jaytektas/grblHAL_CNC/grblHAL.jpg

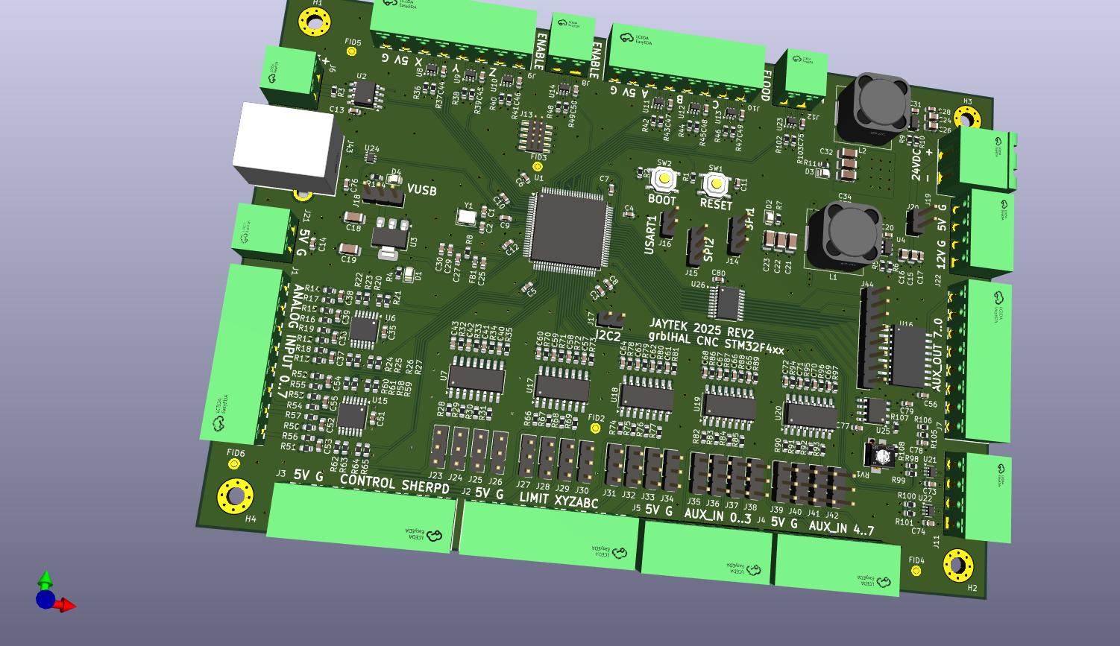
grblHAL.jpg
