jaytektas/grblHAL_CNC/user manual.odt

# JAYTEK Controller User Manual Index

## <a id="index-1-introduction"></a>1. Introduction

- 1.1 Welcome and Overview (https://www.google.com/search?q=%23section-1-1-welcome-and-overview)
- 1.2 Safety Precautions (https://www.google.com/search?q=%23section-1-2-safety-precautions)
  - Electrical Safety (https://www.google.com/search?q=%23section-1-2-electrical-safety)
  - Mechanical Safety (https://www.google.com/search?q=%23section-1-2-mechanical-safety)
  - Fire Safety (https://www.google.com/search?q=%23section-1-2-fire-safety)
  - General Workshop Safety (https://www.google.com/search?q=%23section-1-2-general-workshop-safety)
  - Disclaimer (https://www.google.com/search?q=%23section-1-2-disclaimer)
- 1.3 About GRBLHAL (https://www.google.com/search?q=%23section-1-3-about-grblhal)

## <a id="index-2-controller-features-and-specifications"></a>2. Controller Features and Specifications

- 2.1 Key Features Summary (https://www.google.com/search?q=%23section-2-1-key-features-summary)
- 2.2 Technical Specifications (https://www.google.com/search?q=%23section-2-2-technical-specifications)
  - Microcontroller (https://www.google.com/search?q=%23section-2-2-microcontroller)
  - Power Supply (https://www.google.com/search?q=%23section-2-2-power-supply)
  - Motion Control (https://www.google.com/search?q=%23section-2-2-motion-control)
  - Connectivity (https://www.google.com/search?q=%23section-2-2-connectivity)
  - Physical (https://www.google.com/search?q=%23section-2-2-physical)

## <a id="index-3-hardware-overview-and-connections"></a>3. Hardware Overview and Connections

- 3.1 Board Layout Diagram (https://www.google.com/search?q=%23section-3-1-board-layout-diagram)
- 3.2 Pinout Diagrams / Tables (https://www.google.com/search?q=%23section-3-2-pinout-diagrams-tables)
  - CONTROL INPUT - J3 (https://www.google.com/search?q=%23section-3-2-control-input-j3)
  - LIMIT INPUT – J2 (https://www.google.com/search?q=%23section-3-2-limit-input-j2)
  - DIGITAL 0..3 INPUT – J5 (https://www.google.com/search?q=%23section-3-2-digital-0-3-input-j5)
  - DIGITAL 4..7 INPUT – J4 (https://www.google.com/search?q=%23section-3-2-digital-4-7-input-j4)
  - SPINDLE OUTPUT – J11 (https://www.google.com/search?q=%23section-3-2-spindle-output-j11)
  - AUXILIARY OUTPUT – J7 (https://www.google.com/search?q=%23section-3-2-auxiliary-output-j7)
  - 5 & 12V OUTPUT – J22 (https://www.google.com/search?q=%23section-3-2-5-12v-output-j22)
  - 12 – 24VDC IN SUPPLY – J19 (https://www.google.com/search?q=%23section-3-2-12-24vdc-in-supply-j19)
  - COOLANT OUTPUT – J12 (https://www.google.com/search?q=%23section-3-2-coolant-output-j12)
  - ABC STEP OUTPUT – J10 (https://www.google.com/search?q=%23section-3-2-abc-step-output-j10)
  - ENABLE OUTPUT – J8 (https://www.google.com/search?q=%23section-3-2-enable-output-j8)
  - XYZ STEP OUTPUT – J9 (https://www.google.com/search?q=%23section-3-2-xyz-step-output-j9)
  - RS485 OUTPUT – J6 (https://www.google.com/search?q=%23section-3-2-rs485-output-j6)
  - 5V OUT – J21 (https://www.google.com/search?q=%23section-3-2-5v-out-j21)
  - ANALOG INPUT – J1 (https://www.google.com/search?q=%23section-3-2-analog-input-j1)
- 3.3 Axis Stepper Motor Connections (https://www.google.com/search?q=%23section-3-3-axis-stepper-motor-connections)
  - 3.3.1 Control Signal Connections (JAYTEK Controller to Stepper Driver) (https://www.google.com/search)
  - 3.3.2 Motor Coil Connections (Stepper Driver to Stepper Motor) (https://www.google.com/search)
  - 3.3.3 Power Connections (Stepper Driver) (https://www.google.com/search?q=%23section-3-3-3-power-connections-stepper-driver)
- 3.4 Spindle Control Output (https://www.google.com/search?q=%23section-3-4-spindle-control-output)
  - 3.4.1 Connecting to a Variable Frequency Drive (VFD) (https://www.google.com/search?q=%23section-3-4-1-connecting-to-a-variable-frequency-drive-vfd)
  - 3.4.2 Connecting to an External DC Motor Driver (https://www.google.com/search?q=%23section-3-4-2-connecting-to-an-external-dc-motor-driver)
  - 3.4.3 RS485 Spindle Control (https://www.google.com/search?q=%23section-3-4-3-rs485-spindle-control)
- 3.5 Limit Switch and Probe Connections (https://www.google.com/search?q=%23section-3-5-limit-switch-and-probe-connections)
  - 3.5.1 Limit Switch Inputs (https://www.google.com/search?q=%23section-3-5-1-limit-switch-inputs)
  - 3.5.2 Probe Input (https://www.google.com/search?q=%23section-3-5-2-probe-input)
  - 3.5.3 Control Inputs (Feed Hold, Cycle Start/Resume, Reset) (https://www.google.com/search?q=%23section-3-5-3-control-inputs-feed-hold-cycle-start-resume-reset)
  - 3.5.4 Emergency Stop (E-Stop) (https://www.google.com/search?q=%23section-3-5-4-emergency-stop-e-stop)
- 3.6 Coolant Outputs (Mist and Flood) (https://www.google.com/search?q=%23section-3-6-coolant-outputs-mist-and-flood)
- 3.7 Auxiliary Outputs (J7) (https://www.google.com/search?q=%23section-3-7-auxiliary-outputs-j7)
- 3.8 Expansion Breakouts (UART, I2C, SPI) (https://www.google.com/search?q=%23section-3-8-expansion-breakouts-uart-i2c-spi)
  - 3.8.1 UART (USART) Breakout (https://www.google.com/search?q=%23section-3-8-1-uart-usart-breakout)
  - 3.8.2 I2C (Inter-Integrated Circuit) Breakout (https://www.google.com/search?q=%23section-3-8-2-i2c-inter-integrated-circuit-breakout)
  - 3.8.3 SPI (Serial Peripheral Interface) Breakout (https://www.google.com/search?q=%23section-3-8-3-spi-serial-peripheral-interface-breakout)
- 3.9 Firmware Flashing via DFU (Device Firmware Upgrade) (https://www.google.com/search?q=%23section-3-9-firmware-flashing-via-dfu-device-firmware-upgrade)
  - Method 1: Entering DFU Mode via Hard Reset (when initially unpowered or only USB powered) (https://www.google.com/search)
  - Method 2: Entering DFU Mode via Soft Reset (when already powered via J19 or USB) (https://www.google.com/search)
  - Flashing the Firmware (https://www.google.com/search?q=%23section-3-9-flashing-the-firmware)
- 3.10 Powering the Controller (https://www.google.com/search?q=%23section-3-10-powering-the-controller)
  - 3.10.1 Main Power Input (J19) (https://www.google.com/search?q=%23section-3-10-1-main-power-input-j19)
  - 3.10.2 USB Power (https://www.google.com/search?q=%23section-3-10-2-usb-power)
    - 3.10.2.1 CPU 3.3V Derivation (J18) (https://www.google.com/search?q=%23section-3-10-2-1-cpu-3-3v-derivation-j18)
  - 3.10.3 On-board Power Supply Outputs (https://www.google.com/search?q=%23section-3-10-3-on-board-power-supply-outputs)
  - 3.10.4 Isolated Grounding Philosophy (https://www.google.com/search?q=%23section-3-10-4-isolated-grounding-philosophy)

# JAYTEK Controller User Manual

## <a id="section-1-introduction"></a>1. Introduction

### <a id="section-1-1-welcome-and-overview"></a>1.1 Welcome and Overview

Welcome to the user manual for your new JAYTEK controller! This powerful and versatile controller is designed to be the brain of your CNC machine, translating digital commands into precise physical movements. Whether you're a dedicated hobbyist or managing a small workshop, the JAYTEK controller provides the robust control you need for accurate and efficient machining.

This manual will guide you through the setup, configuration, and operation of your JAYTEK controller, helping you unlock its full potential for your CNC projects.

### <a id="section-1-2-safety-precautions"></a>1.2 Safety Precautions

This section is CRITICAL for your safety and the longevity of your equipment. Please read it carefully and adhere to all warnings.

#### <a id="section-1-2-electrical-safety"></a>Electrical Safety:

- Always disconnect power from the JAYTEK controller and all connected components (spindle, stepper drivers, power supplies) before performing any wiring, maintenance, or inspection.
- Ensure proper grounding of your CNC machine frame and high-power electrical components (like stepper driver power supplies and VFDs). For the JAYTEK controller itself, adhere to the isolated grounding philosophy (https://www.google.com/search?q=%23section-3-10-4-isolated-grounding-philosophy) to protect its sensitive electronics from noise. Improper grounding or incorrect isolation can lead to electrical shock and damage.
- Never operate the controller or machine with damaged cables or exposed wires.
- Verify that your power supply voltage and current ratings are compatible with the JAYTEK controller's requirements (Max 30VDC input). Over-voltage can cause irreparable damage.
- Avoid contact with live circuits. If you are not comfortable working with electrical components, seek assistance from a qualified electrician.

#### <a id="section-1-2-mechanical-safety"></a>Mechanical Safety:

- Be aware of moving parts of the CNC machine. Keep hands, clothing, and long hair clear of the spindle, gantry, and other moving axes.
- Identify and avoid pinch points where moving parts could trap body parts or clothing.
- Always wear appropriate eye protection (safety glasses or a face shield) when operating the CNC machine to guard against flying debris.
- Ensure all mechanical components are securely fastened before operation.

#### <a id="section-1-2-fire-safety"></a>Fire Safety:

- The spindle and power supplies can generate heat. Ensure adequate ventilation around all components to prevent overheating.
- Keep a fire extinguisher (appropriate for electrical and material fires) readily accessible in your workshop.
- Be cautious when machining materials that produce flammable dust or fumes.
- Regularly clean dust and debris from your machine and workspace to reduce fire hazards.

#### <a id="section-1-2-general-workshop-safety"></a>General Workshop Safety:

- Maintain a clean and organized workspace to minimize tripping hazards and improve overall safety.
- Do not operate the CNC machine while under the influence of alcohol, drugs, or medications that impair judgment.
- Familiarize yourself with the emergency stop (E-stop) procedure and ensure it is easily accessible and functional.
- Never leave the machine unattended during operation, especially during long cuts.

#### <a id="section-1-2-disclaimer"></a>Disclaimer:

Incorrect installation, configuration, or use of the JAYTEK controller and associated CNC machinery can lead to serious injury, property damage, or fire. The user assumes all risks associated with the assembly, operation, and maintenance of their CNC system. It is the user's responsibility to understand and comply with all applicable safety regulations and best practices.

### <a id="section-1-3-about-grblhal"></a>1.3 About GRBLHAL

GRBLHAL is an open-source, high-performance, and highly optimized firmware specifically designed for 32-bit microcontrollers, such as the STM32 series. It serves as a powerful control system for CNC machines, taking G-code commands and translating them into precise real-time movements of the machine's axes.

GRBLHAL was chosen for this controller due to its significant advantages over traditional 8-bit GRBL versions:

- Increased Processing Power: The STM32F4xx microcontroller offers considerably more processing power, allowing for smoother motion, faster communication, and the ability to handle more complex calculations and features without stuttering.
- Enhanced Features: Its 32-bit architecture supports advanced functionalities like 6-axis control, more versatile spindle options, and expanded input/output capabilities, which are fully utilized by this controller.
- Reliability and Stability: GRBLHAL is known for its robust and stable performance, crucial for precise CNC operations.
- Active Community and Development: Being open-source, GRBLHAL benefits from continuous development and a large, supportive community, ensuring ongoing improvements and resources.

For more in-depth information about GRBLHAL, including its source code, documentation, and community forums, please visit the official GRBLHAL repository on GitHub:

- GRBLHAL GitHub Repository: https://github.com/grblHAL/grblHAL (https://www.google.com/search?q=https://github.com/grblHAL/grblHAL)
- JAYTEK Controller (STM32F4xx) Specific Firmware: https://github.com/jaytektas/STM32F4xx (https://www.google.com/search?q=https://github.com/jaytektas/STM32F4xx)

## <a id="section-2-controller-features-and-specifications"></a>2. Controller Features and Specifications

### <a id="section-2-1-key-features-summary"></a>2.1 Key Features Summary

The JAYTEK controller is engineered with a comprehensive set of features to provide robust and flexible control for a variety of CNC applications. Below is a summary of its core capabilities:

- Six-Axis Control: The controller supports 6 axes (X, Y, Z, A, B, C). X, Y, and Z are generally used for primary linear motion. Axes A, B, and C can be configured for rotary, additional linear, or specialized applications. Note: The controller's default firmware is configured for auto-squaring during homing, ganging the C-axis with the Y-axis to facilitate this feature.
- PWM Spindle Control: Integrated Pulse Width Modulation (PWM) spindle control allows for precise management of spindle speed. This typically supports a 0-10V analog output for variable frequency drives (VFDs) and a PWM output for direct control of compatible spindles or solid-state relays. The RPM range is software-configurable, allowing you to match your specific spindle's capabilities. Additionally, dedicated enable and direction pins provide comprehensive spindle management, along with RS485 support for advanced communication with intelligent spindles.
- USB Connectivity: High-speed USB communication provides a reliable and fast interface with your host PC. This connection is used for sending G-code, receiving status updates, and configuring the controller. The controller can also be powered via USB for bench programming and initial setup without requiring an external power supply.
- UART Breakout: Multiple Universal Asynchronous Receiver/Transmitter (UART) breakout pins are available, providing serial communication capabilities. These can be utilized for connecting external displays, Bluetooth modules, Wi-Fi modules, or other serial-enabled peripherals to expand the controller's functionality.
- I2C Breakout: Inter-Integrated Circuit (I2C) breakout pins offer a two-wire serial bus interface. This is ideal for connecting various I2C-compatible sensors (e.g., temperature, pressure, accelerometer), real-time clocks, or character LCDs to provide additional feedback or control.
- SPI Breakout: Serial Peripheral Interface (SPI) breakout pins are provided for high-speed synchronous serial communication. SPI is suitable for interfacing with additional peripherals such as SD card readers, advanced sensors, or other modules that require fast data exchange.
- Dual On-board Power Supply (12V and 5V @ 3A): The controller integrates dual onboard Switching Mode Power Supplies (SMPS) that provide regulated 12V and 5V outputs, each capable of supplying up to 3 Amperes of current. This eliminates the need for external power regulation for many connected peripherals, simplifying wiring and reducing component count. These supplies are derived from the main 30VDC input. It's important to consider the total power draw of all connected devices to ensure these supplies are not overloaded.
- Status LEDs: The JAYTEK controller includes clear status LEDs for 12V, 5V, 3.3V, and USB power. These indicators provide immediate visual feedback on the power status of critical internal rails and the USB connection, aiding in troubleshooting and verification.
- Input/Output Pins: A comprehensive array of input/output (I/O) pins is available for essential machine control and safety features:
  - Limit Switches: Individual axis limit stop inputs for all 6 axes ensure the machine operates within safe physical boundaries.
  - Probe Input: A dedicated probe input allows for precise tool length measurement, work coordinate system setting, and automatic leveling.
  - Control Inputs: Dedicated inputs for E-stop (emergency stop), Cycle Start, Hold (pause), Resume, Reset, and Door interlock provide critical operator control and safety mechanisms.
  - Coolant Outputs: Mist and flood coolant outputs allow for automated control of cutting fluid delivery, improving tool life and surface finish.
  - Auxiliary Digital Inputs (8x opto-isolated): These inputs can be used for a wide range of custom functions, such as tool changers, vacuum pumps, dust collection, or additional safety interlocks. The opto-isolation provides protection against electrical noise and ground loops for critical inputs.
  - Auxiliary Analog Inputs (8x): These inputs can be used for various analog sensors, suchs as temperature, pressure, or custom feedback systems.
  - Auxiliary Low-Side Drivers (8x): These outputs are capable of driving relays, small solenoids, or LED indicators, providing additional control capabilities for various machine accessories.

### <a id="section-2-2-technical-specifications"></a>2.2 Technical Specifications

#### <a id="section-2-2-microcontroller"></a>Microcontroller

- Model: STM32F407VET6

#### <a id="section-2-2-power-supply"></a>Power Supply

- Input Voltage Range: 12V-30V DC (preferred 24V DC for main power)
- On-board Power Supply Outputs:
  - 12V @ 3A
  - 5V @ 3A

#### <a id="section-2-2-motion-control"></a>Motion Control

- Number of Axes: 6
- Stepper Driver Interface: Step/Dir/Enable signals, compatible with common drivers such as A4988, DRV8825, TMC2209, DM542, and DM556.
- Spindle Control: PWM (Pulse Width Modulation) & Analog 0 - 10V
  - Frequency: (To be specified based on requirements, e.g., 1kHz typical)
  - Duty Cycle Range: 0-100%

#### <a id="section-2-2-connectivity"></a>Connectivity

- USB: USB-B port
- Pin Headers for Communication Protocols:
  - UART
  - I2C
  - SPI

#### <a id="section-2-2-physical"></a>Physical

- Dimensions: 150mm x 105mm
- Mounting Holes: 4 mounting holes, 3.2mm diameter, located 6mm from each corner (X and Y)
  - Coordinates (assuming origin at bottom-left corner):
    - (6mm, 6mm)
    - (144mm, 6mm)
    - (6mm, 99mm)
    - (144mm, 99mm)

## <a id="section-3-hardware-overview-and-connections"></a>3. Hardware Overview and Connections

### <a id="section-3-1-board-layout-diagram"></a>3.1 Board Layout Diagram

(Image or Diagram Placeholder - Please refer to your physical manual or JAYTEK documentation for the actual diagram.)

### <a id="section-3-2-pinout-diagrams-tables"></a>3.2 Pinout Diagrams / Tables

Note on Connectors: All connectors on the JAYTEK controller are removable terminal blocks. This design feature significantly simplifies the wiring process. Users can detach the individual connector blocks from their sockets, comfortably install wires into the screw terminals, and then securely push the wired connector blocks back into their corresponding sockets on the board. This eliminates the need to work with wires directly on the mounted board.

#### <a id="section-3-2-control-input-j3"></a>CONTROL INPUT - J3

PIN | FUNCTION | DIRECTION
1 | 5V | OUT
2 | GND | COMMON
3 | CYCLE START | IN
4 | CYCLE HOLD | IN
5 | EMERGENCY STOP | IN
6 | RESET | IN
7 | PROBE | IN
8 | DOOR | IN

#### <a id="section-3-2-limit-input-j2"></a>LIMIT INPUT – J2

PIN | FUNCTION | DIRECTION
1 | 5V | OUT
2 | GND | COMMON
3 | LIMIT X | IN
4 | LIMIT Y | IN
5 | LIMIT Z | IN
6 | LIMIT A | IN
7 | LIMIT B | IN
8 | LIMIT C | IN

#### <a id="section-3-2-digital-0-3-input-j5"></a>DIGITAL 0..3 INPUT – J5

PIN | FUNCTION | DIRECTION
1 | 5V | OUT
2 | GND | COMMON
3 | AUXILIARY INPUT 0 | IN
4 | AUXILIARY INPUT 1 | IN
5 | AUXILIARY INPUT 2 | IN
6 | AUXILIARY INPUT 3 | IN

#### <a id="section-3-2-digital-4-7-input-j4"></a>DIGITAL 4..7 INPUT – J4

PIN | FUNCTION | DIRECTION
1 | 5V | OUT
2 | GND | COMMON
3 | AUXILIARY INPUT 4 | IN
4 | AUXILIARY INPUT 5 | IN
5 | AUXILIARY INPUT 6 | IN
6 | AUXILIARY INPUT 7 | IN

#### <a id="section-3-2-spindle-output-j11"></a>SPINDLE OUTPUT – J11

PIN | FUNCTION | DIRECTION
1 | SPINDLE 5V PWM | OUT
2 | SPINDLE ENABLE | OUT
3 | SPINDLE DIRECTION | OUT
4 | SPINDLE SPEED ANALOG 0-10V | OUT

#### <a id="section-3-2-auxiliary-output-j7"></a>AUXILIARY OUTPUT – J7

PIN | FUNCTION | DIRECTION
1 | AUXILIARY #7 | OUT
2 | AUXILIARY #6 | OUT
3 | AUXILIARY #5 | OUT
4 | AUXILIARY #4 | OUT
5 | AUXILIARY #3 | OUT
6 | AUXILIARY #2 | OUT
7 | AUXILIARY #1 | OUT
8 | AUXILIARY #0 | OUT

#### <a id="section-3-2-5-12v-output-j22"></a>5 & 12V OUTPUT – J22

PIN | FUNCTION | DIRECTION
1 | +12V | OUT
2 | GND | COMMON
3 | +5V | OUT
4 | GND | COMMON

#### <a id="section-3-2-12-24vdc-in-supply-j19"></a>12 – 24VDC IN SUPPLY – J19

PIN | FUNCTION | DIRECTION
1 | GND | COMMON
2 | +12V | IN

#### <a id="section-3-2-coolant-output-j12"></a>COOLANT OUTPUT – J12

PIN | FUNCTION | DIRECTION
1 | MIST | OUT
2 | FLOOD | OUT

#### <a id="section-3-2-abc-step-output-j10"></a>ABC STEP OUTPUT – J10

PIN | FUNCTION | DIRECTION
1 | STEP C | OUT
2 | DIRECTION C | OUT
3 | STEP B | OUT
4 | DIRECTION B | OUT
5 | STEP A | OUT
6 | DIRECTION A | OUT
7 | GND | COMMON
8 | +5V | OUT

#### <a id="section-3-2-enable-output-j8"></a>ENABLE OUTPUT – J8

PIN | FUNCTION | DIRECTION
1 | ENABLE | OUT
2 | ENABLE | OUT

#### <a id="section-3-2-xyz-step-output-j9"></a>XYZ STEP OUTPUT – J9

PIN | FUNCTION | DIRECTION
1 | STEP Z | OUT
2 | DIRECTION Z | OUT
3 | STEP Y | OUT
4 | DIRECTION Y | OUT
5 | STEP X | OUT
6 | DIRECTION X | OUT
7 | GND | COMMON
8 | +5V | OUT

#### <a id="section-3-2-rs485-output-j6"></a>RS485 OUTPUT – J6

PIN | FUNCTION | DIRECTION
1 | RS485+ | IN/OUT
2 | RS485- | IN/OUT

#### <a id="section-3-2-5v-out-j21"></a>5V OUT – J21

PIN | FUNCTION | DIRECTION
1 | +5V | OUT
2 | GND | COMMON

#### <a id="section-3-2-analog-input-j1"></a>ANALOG INPUT – J1

PIN | FUNCTION | DIRECTION
1 | ANALOG #0 | OUT
2 | ANALOG #1 | OUT
3 | ANALOG #2 | OUT
4 | ANALOG #3 | OUT
5 | ANALOG #4 | OUT
6 | ANALOG #5 | OUT
7 | ANALOG #6 | COMMON
8 | ANALOG #7 | OUT

### <a id="section-3-3-axis-stepper-motor-connections"></a>3.3 Axis Stepper Motor Connections

Wiring Stepper Drivers and Motors: Stepper motors are the workhorses of your CNC machine, translating electrical pulses into precise rotational movements. These motors are controlled by stepper drivers, which act as intermediaries, taking low-power control signals from your JAYTEK controller and converting them into the higher-power pulses needed to drive the motor coils. This section details the critical connections required for your stepper motors to function correctly:

- Control Signal Connections: How your JAYTEK controller communicates with each stepper driver.
- Motor Coil Connections: How each stepper driver connects to its respective stepper motor.
- Power Connections: Providing the necessary power to the stepper drivers.

We will focus on common bipolar stepper motors with 4 wires, as these are most prevalent in CNC applications, and drivers that use the standard "Step/Dir/Enable" interface.

#### <a id="section-3-3-1-control-signal-connections-jaytek-controller-to-stepper-driver"></a>3.3.1 Control Signal Connections (JAYTEK Controller to Stepper Driver)

Your JAYTEK controller provides dedicated Step, Direction, and combined Enable signals for each of its 6 axes (X, Y, Z, A, B, C). These are 5V logic signals. Each stepper driver will have corresponding inputs to receive these signals.

Common Control Signal Pins on Stepper Drivers:

- STEP (or PUL, PULS, CP): This input receives a pulsed signal from the controller. Each pulse instructs the stepper motor to advance by one "step" (or microstep, depending on your driver's settings).
  - Connect the STEP_X pin from your JAYTEK controller (e.g., J9 Pin 5 for X-axis) to the STEP input on your X-axis stepper driver.
  - Repeat this for all other axes (Y, Z, A, B, C), using the corresponding STEP pins from J9 (for Y, Z) and J10 (for A, B, C).
- DIR (or CW/CCW, D): This input receives a high (e.g., 5V) or low (e.g., 0V) voltage signal from the controller that determines the direction of the motor's rotation.
  - Connect the DIRECTION_X pin from your JAYTEK controller (e.g., J9 Pin 6 for X-axis) to the DIR input on your X-axis stepper driver.
  - Repeat for all other axes, connecting the corresponding DIRECTION pins.
- EN (or ENA, ENABLE): This input enables or disables the motor driver. When enabled (typically active low, meaning a low voltage or connection to ground activates it), the driver will hold the motor in position and respond to Step/Dir signals. When disabled (high voltage or sometimes left unconnected), the motor is free to spin.
  - Connect the common ENABLE pin from your JAYTEK controller (J8 Pin 1 or 2) to the EN input on all of your stepper drivers. The JAYTEK board provides a single common enable signal for all connected drivers.

Ground Connection for Control Signals (Signal Reference): It is critical to establish a common signal ground reference between the JAYTEK controller and your stepper drivers. Connect a GND pin from your JAYTEK controller (e.g., J9 Pin 7 or J10 Pin 7, or any common GND pin from J2, J3, J19, J21, J22) to the logic ground (often labeled GND, DGND, or SGND) input on each of your stepper drivers. This connection is solely for signal referencing and should not be used to carry the high-current return path of the stepper motor power supply.

Note: Ideally, your stepper drivers feature opto-isolated inputs, which provide a complete electrical separation between the JAYTEK controller's logic and the high-power section of the stepper driver. If your drivers are not opto-isolated, this shared signal ground is necessary for the control signals to function correctly, but ensure the power grounds remain separate as per the isolated grounding philosophy (https://www.google.com/search?q=%23section-3-10-4-isolated-grounding-philosophy).

Example Wiring for an X-Axis Stepper Driver (Conceptual):

JAYTEK Controller Pin (from J9/J8) | Stepper Driver Pin (X-Axis) | Description
STEP X (J9 Pin 5) | STEP | Pulse input for motor movement
DIRECTION X (J9 Pin 6) | DIR | Direction input for motor rotation
ENABLE (J8 Pin 1 or 2) | EN | Enable/Disable the motor driver
GND (J9 Pin 7) | GND (Logic/Signal Ground) | Signal ground reference for control

#### <a id="section-3-3-2-motor-coil-connections-stepper-driver-to-stepper-motor"></a>3.3.2 Motor Coil Connections (Stepper Driver to Stepper Motor)

Stepper motors contain multiple coils (typically two for bipolar motors). The stepper driver precisely sequences power through these coils to achieve microstep-level rotation. Most bipolar stepper motors used in CNC will have 4 wires.

Common Motor Coil Terminals on Stepper Drivers:

- A+, A- (or 1A, 1B): These terminals connect to one coil of your stepper motor.
- B+, B- (or 2A, 2B): These terminals connect to the second coil of your stepper motor.

Identifying Stepper Motor Wires: If your 4-wire bipolar stepper motor's wires are not clearly labeled (e.g., by color code for A+, A-, B+, B-), you'll need to identify the two coil pairs:

- Method 1: Using a Multimeter (Resistance Check)
  - Set your multimeter to measure resistance (Ohms, Omega).
  - Take any one wire from the motor and touch one probe to it.
  - Touch the other multimeter probe to the remaining wires one by one.
  - When you find another wire that shows a low resistance reading (typically 1-10 Ohms for a CNC stepper motor) with the first wire, you've identified a pair that belongs to the same coil.
  - The remaining two wires will automatically form the second coil pair.
- Method 2: "Twist and Feel" (Manual Check)
  - Take any two wires from the motor and temporarily twist their bare ends together (or connect them).
  - Try to manually rotate the motor shaft.
  - If you feel significant resistance or a noticeable "detent" effect, these two wires belong to the same coil.
  - If not, try another combination until you find a pair that creates resistance when shorted. The remaining two wires will be the second coil.

Connecting the Motor Wires: Once you have identified the two coil pairs, connect one pair to the A+/A- terminals on your driver and the other pair to the B+/B- terminals. The exact wire for A+ vs. A- within a pair generally doesn't matter initially, as it only affects the direction of rotation.

Adjusting Direction: If your motor spins in the wrong direction during testing (e.g., X+ movement results in physical X- movement), you can easily reverse its direction. To do this, simply reverse the polarity of one of the coil pairs on the driver. For example, if you connected CoilA_Wire1 to A+ and CoilA_Wire2 to A-, swap them so CoilA_Wire2 goes to A+ and CoilA_Wire1 goes to A-. Do NOT reverse both coil pairs, as this will not change the direction. Alternatively, motor direction can often be inverted in GRBLHAL software settings ($3 for axis direction invert mask).

Example Wiring for an X-Axis Stepper Motor (Conceptual):

Stepper Driver Terminal | Stepper Motor Wire (Example)
A+ | Coil A Wire 1
A- | Coil A Wire 2
B+ | Coil B Wire 1
B- | Coil B Wire 2

#### <a id="section-3-3-3-power-connections-stepper-driver"></a>3.3.3 Power Connections (Stepper Driver)

Stepper drivers require a dedicated, higher-voltage DC power supply to energize the motor coils and generate torque. This power supply is separate from the JAYTEK controller's own power input (J19).

Common Power Input Terminals on Stepper Drivers:

- VMOT (or VCC, V+, HV): This is the main positive (+) power input for the motor coils.
- GND (Power Ground): This is the negative (-) or ground connection for the main power supply.

Connecting the External Motor Power Supply:

- Connect the positive (+) terminal of your dedicated motor power supply to the VMOT (or equivalent) input on each of your stepper drivers.
- Connect the negative (-) terminal (ground) of your dedicated motor power supply to the GND (power ground) input on each of your stepper drivers.

Important Grounding Note (Isolation): As per the isolated grounding philosophy (https://www.google.com/search?q=%23section-3-10-4-isolated-grounding-philosophy), the power ground of your dedicated motor power supply should be kept separate from the JAYTEK controller's main input power ground. The connection between the controller and the stepper driver grounds should be limited to the signal ground reference for the Step/Dir/Enable lines, not for carrying the high-current return path of the stepper motor power supply. This helps prevent noise from the motor circuits from affecting the controller's performance.

Example Wiring for Stepper Driver Power (Conceptual):

External Motor Power Supply | Stepper Driver Terminal | Description
+ (Positive Output) | VMOT | Main power input for motor coils
- (Negative/Ground Output) | GND (Power Ground) | Ground connection for motor power

Important Power Considerations:

- Voltage Selection: Choose a motor power supply voltage that is within the operating range of your stepper drivers and appropriate for your stepper motors. Higher voltage generally allows for better high-speed performance (higher RPMs) from your motors, up to their rated voltage limits.
- Current Rating: Ensure your external motor power supply has sufficient current capacity to power all your stepper drivers and motors simultaneously, especially during rapid movements or simultaneous axis operation.
- Dedicated Power: Do not attempt to power your stepper drivers directly from the JAYTEK controller's 5V or 12V onboard outputs (J22), as these are low-current supplies intended for sensors and auxiliary components, not high-power motor drivers.

Conceptual Overall Stepper Wiring Flow:

(Image or Diagram Placeholder - Please refer to your physical manual or JAYTEK documentation for the actual diagram.)

### <a id="section-3-4-spindle-control-output"></a>3.4 Spindle Control Output

The JAYTEK controller offers versatile control over your CNC spindle, supporting both Pulse Width Modulation (PWM) and a 0-10V analog output, along with dedicated enable and direction signals. This allows for seamless integration with various spindle types, including those driven by Variable Frequency Drives (VFDs) or external DC motor drivers. The spindle control signals are available on the SPINDLE OUTPUT – J11 header:

PIN | FUNCTION | DIRECTION
1 | SPINDLE 5V PWM | OUT
2 | SPINDLE ENABLE | OUT
3 | SPINDLE DIRECTION | OUT
4 | SPINDLE SPEED ANALOG 0-10V | OUT

Understanding the Spindle Control Pins:

- SPINDLE 5V PWM (J11 Pin 1): This pin outputs a 5V Pulse Width Modulation signal. The duty cycle of this PWM signal is directly proportional to the desired spindle speed, as commanded by your G-code (M3/M4 with S-value). This is commonly used for:
  - Direct control of compatible DC spindles that accept a PWM input.
  - Interfacing with solid-state relays (SSRs) to switch AC power for simple ON/OFF AC spindles (though the analog output is often preferred for VFDs).
  - As an input to some VFDs that can interpret a PWM signal for speed control.
- SPINDLE ENABLE (J11 Pin 2): This digital output pin goes high (active) when the spindle is commanded to turn ON (e.g., by an M3 or M4 G-code command) and low (inactive) when commanded OFF (M5). This signal is crucial for:
  - Enabling the VFD or external motor driver.
  - Activating a relay or contactor to supply power to the spindle.
- SPINDLE DIRECTION (J11 Pin 3): This digital output pin indicates the commanded direction of spindle rotation. It will be high for clockwise (CW) rotation (M3) and low for counter-clockwise (CCW) rotation (M4). This signal is used by:
  - VFDs that support direction control input.
  - Reversible DC motor drivers.
- SPINDLE SPEED ANALOG 0 - 10V (J11 Pin 4): This pin provides a linear analog voltage output ranging from 0V to 10V. The voltage level corresponds to the commanded spindle speed (S-value). This is the most common and preferred method for controlling the speed of a VFD.
  - 0V typically represents 0 RPM (spindle off or minimum speed).
  - 10V typically represents the maximum configured RPM.
  Important Note: For the 0-10V analog output to function correctly, the JAYTEK controller's onboard 12V power supply must be enabled. This is achieved by ensuring the main power input (J19) is connected and providing power to the board, and that the J20 jumper is in place to enable the 12V supply.

Ground (Signal Reference): It is critical to connect the signal ground of your spindle control circuit to a common GND pin on the JAYTEK controller (e.g., any GND pin on J2, J3, J9, J10, J19, J21, J22). This connection provides a reference for all control signals (PWM, Enable, Direction, and Analog) to the VFD or external driver. As per the isolated grounding philosophy (https://www.google.com/search?q=%23section-3-10-4-isolated-grounding-philosophy), this ground connection should be for signal referencing only, and the VFD/driver's main power ground should remain separate.

#### <a id="section-3-4-1-connecting-to-a-variable-frequency-drive-vfd"></a>3.4.1 Connecting to a Variable Frequency Drive (VFD)

VFDs are commonly used to control 3-phase AC spindles, allowing for precise speed and direction control. The JAYTEK controller provides all the necessary signals for this.

Analog Speed Control (Recommended):

- Connect the SPINDLE SPEED ANALOG 0 - 10V (J11 Pin 4) from the JAYTEK controller to the VFD's analog input terminal (often labeled VI, AIN1, 0-10V, or similar).
- Connect a GND pin from the JAYTEK controller to the VFD's analog ground terminal (often labeled GND, COM, or ACM). This is for signal reference.
- You will need to configure your VFD to accept a 0-10V analog signal for speed control and set its maximum frequency/RPM to match your spindle.

Spindle Enable/Run:

- Connect the SPINDLE ENABLE (J11 Pin 2) from the JAYTEK controller to a digital input on your VFD that is configured as a "Run" or "Start" command (often labeled FWD, DI1, or RUN).
- Connect a GND pin from the JAYTEK controller to the VFD's digital input common (often labeled DCOM or GND). This is for signal reference.
- Configure the VFD to trigger its run state when this input is active (typically high).

Spindle Direction:

- Connect the SPINDLE DIRECTION (J11 Pin 3) from the JAYTEK controller to a digital input on your VFD that is configured for direction control (e.g., REV, DI2, or DIR).
- Connect a GND pin from the JAYTEK controller to the VFD's digital input common (if not already connected). This is for signal reference.
- Configure the VFD to interpret this input for forward/reverse operation.

#### <a id="section-3-4-2-connecting-to-an-external-dc-motor-driver"></a>3.4.2 Connecting to an External DC Motor Driver

For DC spindles, an external DC motor driver (often a PWM-controlled H-bridge) is used.

PWM Speed Control:

- Connect the SPINDLE 5V PWM (J11 Pin 1) from the JAYTEK controller to the PWM input on your DC motor driver.
- Connect a GND pin from the JAYTEK controller to the logic ground of your DC motor driver for signal reference.

Spindle Enable:

- Connect the SPINDLE ENABLE (J11 Pin 2) from the JAYTEK controller to the enable input on your DC motor driver.
- Connect a GND pin from the JAYTEK controller to the logic ground of your DC motor driver for signal reference.

Spindle Direction:

- Connect the SPINDLE DIRECTION (J11 Pin 3) from the JAYTEK controller to the direction input on your DC motor driver. This might be a single pin (high/low for direction) or two separate pins (e.g., IN1, IN2 for forward/reverse). Consult your driver's documentation.
- Connect a GND pin from the JAYTEK controller to the logic ground of your DC motor driver for signal reference.

#### <a id="section-3-4-3-rs485-spindle-control"></a>3.4.3 RS485 Spindle Control

The JAYTEK controller also supports RS485 communication, allowing for advanced digital control of intelligent spindles or VFDs that support the Modbus RTU protocol. This method offers more robust communication, feedback capabilities, and often simplifies wiring compared to multiple analog/digital signals. The RS485 communication pins are available on the RS485 OUTPUT – J6 header:

PIN | FUNCTION | DIRECTION
1 | RS485+ | IN/OUT
2 | RS485- | IN/OUT

Connecting to an RS485-enabled VFD/Spindle:

- RS485+ (A): Connect the RS485+ (J6 Pin 1) from the JAYTEK controller to the A or DATA+ terminal on your VFD/spindle.
- RS485- (B): Connect the RS485- (J6 Pin 2) from the JAYTEK controller to the B or DATA- terminal on your VFD/spindle.
- Ground (Signal Reference): While RS485 is differential and less susceptible to ground noise, it is still good practice to ensure a common signal ground reference between the JAYTEK controller and the VFD/spindle's control circuit. Connect a GND pin from the JAYTEK controller to a ground terminal on the VFD/spindle if available and specified for control signal ground.

Configuration for RS485 Control:

- GRBLHAL Configuration: You will need to configure GRBLHAL to enable RS485 control for the spindle and set the appropriate Modbus parameters (e.g., baud rate, parity, slave ID). Refer to the GRBLHAL documentation for specific $xx settings related to RS485/Modbus spindle control.
- VFD/Spindle Configuration: Your VFD or intelligent spindle must also be configured to accept Modbus RTU commands via its RS485 interface. This includes setting its Modbus slave ID, baud rate, data format, and mapping registers for speed, direction, and run/stop commands. Consult your VFD/spindle manual for these critical settings.
- Termination Resistors: For longer RS485 bus lengths or in environments with high electrical noise, you may need to add 120-ohm termination resistors at both ends of the RS485 bus. Consult your VFD/spindle manual for recommendations.

Important Considerations for Spindle Control:

- Isolation: For optimal noise immunity and protection, consider using VFDs or motor drivers with opto-isolated inputs for their control circuits. This helps maintain the electrical separation between the JAYTEK controller's sensitive logic ground and the potentially noisy power grounds of the VFD/spindle.
- VFD Configuration: Always refer to your VFD's specific user manual for detailed wiring diagrams and parameter settings for external control (analog input scaling, run/stop methods, direction control, Modbus parameters). Incorrect VFD configuration is a common source of issues.
- RPM Range: The JAYTEK controller's GRBLHAL firmware allows you to configure the maximum and minimum RPM values ($30 and $31 settings). Ensure these settings match your spindle's capabilities and your VFD's configuration.
- Noise Suppression: Long control wires can pick up electrical noise. Use shielded cables for spindle control signals, especially the analog 0-10V line and RS485, and ensure proper grounding of the cable shield to minimize interference.

### <a id="section-3-5-limit-switch-and-probe-connections"></a>3.5 Limit Switch and Probe Connections

Limit switches and probes are crucial for the safe and precise operation of your CNC machine. They provide feedback to the JAYTEK controller about the machine's physical boundaries and the workpiece's position, preventing crashes and enabling automated processes.

Important Note on Inputs and Opto-Isolation & Configurable Logic: The JAYTEK controller's inputs (including Limit Switches, Probe, E-Stop, and all Auxiliary Digital Inputs) are robustly designed for noise immunity and flexibility. All inputs are buffered with AC opto-isolators. This provides electrical isolation between your machine's potentially noisy external signals and the sensitive microcontroller, preventing ground loops and signal interference.

Crucially, each input's logic can be configured for either active low input or active high input operation via an onboard jumper. These jumpers are typically labeled "INPUT JUMPERS" (refer to the "Board Layout Diagram" for exact jumper locations). This jumper essentially pre-configures one side of the opto-isolator's internal LED, dictating whether the external signal needs to provide 0V (ground) or a positive voltage to activate it.

The internal opto-isolator circuit for each input contains two LEDs (diodes) wired in anti-parallel. The jumper biases one of these LEDs by connecting either its anode to +5VDC or its cathode to GND. When the opposite voltage is applied externally to the input pin, the correctly biased diode will conduct, lighting up the opto-isolator's internal LED. The output of the opto-isolator then changes state (to a logic '1' for its output), signaling the input's activation to the microcontroller.

Key Input Electrical Specifications: When configured via jumper to provide an external positive voltage for activation (i.e., the internal opto-LED's cathode is connected to GND), the inputs are 12V tolerant. There is a 1k Ohm (1k$\Omega$) series resistor on these inputs. The opto-coupler itself can handle a maximum of 60mA current. This robust design allows for direct connection of common 5V or 12V sensors/signals without needing additional external current limiting resistors.

#### <a id="section-3-5-1-limit-switch-inputs"></a>3.5.1 Limit Switch Inputs

The JAYTEK controller provides dedicated inputs for limit switches on all 6 axes (X, Y, Z, A, B, C). These inputs are used for homing the machine (finding its precise home position) and as hard limits to prevent the machine from moving beyond its physical travel limits.

The limit switch inputs are available on the LIMIT INPUT – J2 header:

PIN | FUNCTION | DIRECTION
1 | 5V | OUT
2 | GND | COMMON
3 | LIMIT X | IN
4 | LIMIT Y | IN
5 | LIMIT Z | IN
6 | LIMIT A | IN
7 | LIMIT B | IN
8 | LIMIT C | IN

Configuring Input Logic via Jumper and Wiring Limit Switches:

The jumper settings for each input determine whether the input expects 0V or a positive voltage for activation. Refer to the Board Layout Diagram for the locations of the INPUT JUMPERS.

- Jumper Setting for "Active Low Input" (Requires External 0V/GND for Activation):
  - Internal Configuration: The opto-isolator's internal LED has its anode connected to +5VDC via the jumper.
  - External Signal Required for Activation: To complete the circuit and activate the opto-isolator, you must provide a GND (0V) signal to the corresponding input pin (e.g., LIMIT X). Upon activation, the opto-isolator's output state will be '1'.
  - Typical Devices & Wiring: This configuration is ideal for:
    - Mechanical Switches: Connect the Common (C) terminal of your switch to the LIMIT_AXIS (J2 Pins 3-8) pin. Connect the Normally Open (NO) or Normally Closed (NC) terminal of your switch to a GND (J2 Pin 2) source. When the switch activates, it pulls the input pin to GND.
    - NPN (Sinking) Proximity Sensors: Connect the NPN sensor's signal output to the LIMIT_AXIS pin. Ensure the NPN sensor's power supply ground is common with the JAYTEK controller's ground. When activated, the NPN sensor pulls its output to ground (0V), activating the input.
- Jumper Setting for "Active High Input" (Requires External +Voltage for Activation):
  - Internal Configuration: The opto-isolator's internal LED has its cathode connected to GND via the jumper.
  - External Signal Required for Activation: To complete the circuit and activate the opto-isolator, you must provide an external positive voltage (+3.3V to +12VDC) to the corresponding input pin (e.g., LIMIT X). The internal 1k$\Omega$ series resistor safely limits the current. Upon activation, the opto-isolator's output state will be '1'.
  - Typical Devices & Wiring: This configuration is ideal for:
    - Mechanical Switches: Connect the Common (C) terminal of your switch to the LIMIT_AXIS (J2 Pins 3-8) pin. Connect the Normally Open (NO) or Normally Closed (NC) terminal of your switch to a +5V (J2 Pin 1) or +12V (J22 Pin 1) source. When the switch activates, it provides the positive voltage to the input pin.
    - PNP (Sourcing) Proximity Sensors: Connect the PNP sensor's signal output to the LIMIT_AXIS pin. Ensure the PNP sensor's power supply ground is common with the JAYTEK controller's ground. When activated, the PNP sensor outputs a positive voltage (typically close to its supply voltage, e.g., +12V), activating the input.

Normally Open (NO) vs. Normally Closed (NC) Wiring (for Mechanical Switches):

Regardless of whether you configure the input for active low or active high at the hardware level, the choice between NO and NC mechanical switches is crucial for reliability and safety.

- Normally Open (NO) Configuration:
  - When the switch is not pressed, the circuit is open (no continuity). When pressed, it closes the circuit.
  - Disadvantages: Highly susceptible to electrical noise. If a wire comes loose or breaks, the controller will not detect a limit switch fault, potentially leading to a crash. This is generally not recommended for reliable CNC operation due to safety concerns.
- Normally Closed (NC) Configuration (Recommended for Fail-Safe Operation):
  - When the switch is not pressed, the circuit is closed (continuity). When pressed, it opens the circuit.
  - Advantages:
    - Noise Immunity: More resistant to electrical noise because a continuous current path keeps the input reliably active until triggered.
    - Fail-Safe: If a wire breaks, comes loose, or the switch itself fails (becomes permanently open circuit), the controller immediately detects this as an activated limit switch and triggers an alarm (e.g., Alarm:1 for a hard limit), stopping the machine. This is a critical safety feature.

Connecting Multiple Switches per Axis (Min/Max Limits):

The JAYTEK controller provides a single input pin for each axis (e.g., LIMIT X). To implement both minimum and maximum limits for an axis using physical switches, you need to wire them such that if any switch on that axis is triggered, the single input pin reflects that state.

- Recommended for NC Switches (Series Connection):
  - Wire your X-min and X-max NC switches in series.
  - If Jumper is set for "Active Low Input": Connect one end of this series chain to GND (J2 Pin 2). Connect the other end of the series chain to the LIMIT X (J2 Pin 3) input. If either X-min or X-max switch is triggered, the series circuit breaks (opens), and the LIMIT X input changes state, signaling a limit event. If any wire breaks in this chain, the circuit also breaks, triggering a fail-safe alarm.
  - If Jumper is set for "Active High Input": Connect one end of this series chain to a positive voltage source (+5V from J2 Pin 1 or +12V from J22 Pin 1). Connect the other end of the series chain to the LIMIT X (J2 Pin 3) input. If either X-min or X-max switch is triggered, it closes the circuit, applying the positive voltage to the LIMIT X input. This method is also susceptible to noise and fail-safe issues.
- For NO Switches (Parallel Connection):
  - Wire your X-min and X-max NO switches in parallel.
  - If Jumper is set for "Active Low Input": Connect one side of the parallel connection to GND (J2 Pin 2). Connect the other side of the parallel connection to the LIMIT X (J2 Pin 3) input. If either X-min or X-max switch is triggered, it closes the circuit, pulling the LIMIT X input to GND. This method is susceptible to the same noise and fail-safe issues as single NO switches.
  - If Jumper is set for "Active High Input": Connect one side of the parallel connection to a positive voltage source (+5V from J2 Pin 1 or +12V from J22 Pin 1). Connect the other side of the parallel connection to the LIMIT X (J2 Pin 3) input. If either X-min or X-max switch is triggered, it closes the circuit, applying the positive voltage to the LIMIT X input. This method is also susceptible to noise and fail-safe issues.

Configuration in GRBLHAL ($settings):

After wiring your switches and setting the hardware jumpers, you need to configure GRBLHAL to correctly interpret the logic and enable the desired functions. Access GRBLHAL's settings through your chosen CNC control software by typing $$ into the console.

- $5 - Input port invert mask, int: This crucial setting tells GRBLHAL whether to interpret a physical "low" (0V) or "high" (positive voltage) state on the input pin as "active" or "triggered."
  - Determine the Physical State When Triggered:
    - If your hardware setup (jumper + switch wiring) causes the input pin to go LOW (0V) when a limit switch is triggered, then setting the corresponding bit in $5 to 0 (not inverted) will usually be correct for GRBLHAL to see it as active.
    - If your hardware setup causes the input pin to go HIGH (positive voltage) when a limit switch is triggered, then setting the corresponding bit in $5 to 1 (inverted) will usually be correct for GRBLHAL to see it as active.
  - Bitmask Values for $5:
    - X-limit: 1, Y-limit: 2, Z-limit: 4, A-limit: 8, B-limit: 16, C-limit: 32
    - Probe: 128 (though the probe has its own $6 setting)
    - Hold: 512, Start: 1024, Door: 2048, Reset: 4096, E-Stop: 8192 (these are also $5 bits if you need to invert their logic).
    - Add the values for the inputs you need to invert. For example, if X, Y, and Z limits are wired to go HIGH when triggered, and GRBLHAL expects LOW for active, you would set $5=7 (1+2+4).
  - Testing Input Logic: A simple way to check the input state in GRBLHAL is to type ? in the console. The status report will show Pn:XYZABC if the respective limit switches are currently triggered, and nothing if they are open. Adjust $5 until the Pn: status accurately reflects the physical state of your switches (e.g., Pn:XYZ when all are triggered, Pn: when all are open).
- $20 - Soft limits enable/disable, boolean: (Refer to previous explanation)
- $21 - Hard limits enable/disable, boolean: (Refer to previous explanation)
- $22 - Homing cycle enable/disable, boolean: (Refer to previous explanation)
- $23 - Homing dir invert mask, int: (Refer to previous explanation)
- $25 - Homing feed rate, mm/min: (Refer to previous explanation)
- $26 - Homing locate feed rate, mm/min: (Refer to previous explanation)
- $27 - Homing pull-off distance, mm: (Refer to previous explanation)

#### <a id="section-3-5-2-probe-input"></a>3.5.2 Probe Input

A probe allows your CNC machine to precisely locate surfaces, enabling automated tool length measurement, work coordinate system setting, and even surface mapping. The JAYTEK controller provides a dedicated input for a Z-probe. Like other inputs, the probe input is opto-isolated and its logic can be configured for active low or active high via a jumper, also benefiting from the 12V tolerance and 1k$\Omega$ series resistor when set to accept an external positive voltage.

The probe input is available on the CONTROL INPUT – J3 header:

PIN | FUNCTION | DIRECTION
1 | 5V | OUT
2 | GND | COMMON
3 | CYCLE START | IN
4 | CYCLE HOLD | IN
5 | EMERGENCY STOP | IN
6 | RESET | IN
7 | PROBE | IN
8 | DOOR | IN

Configuring Input Logic via Jumper and Wiring the Probe:

The jumper for the Probe input dictates whether it expects 0V or a positive voltage for activation. Refer to the Board Layout Diagram for the location of the INPUT JUMPERS associated with J3.

- Jumper Setting for "Active Low Input" (Requires External 0V/GND for Activation):
  - Internal Configuration: The opto-isolator's internal LED has its anode connected to +5VDC via the jumper.
  - External Signal Required for Activation: You must provide a GND (0V) signal to the PROBE (J3 Pin 7) pin to activate it. Upon activation, the opto-isolator's output state will be '1'.
  - Wiring for Contact Probes: Connect one lead of your probe (e.g., the clip that attaches to the tool/spindle) to the PROBE (J3 Pin 7). Connect the other lead of your probe (e.g., the contact plate on the spoilboard) to GND (J3 Pin 2). When the tool touches the probe plate, the circuit is completed, pulling the PROBE input pin to GND.
- Jumper Setting for "Active High Input" (Requires External +Voltage for Activation):
  - Internal Configuration: The opto-isolator's internal LED has its cathode connected to GND via the jumper.
  - External Signal Required for Activation: You must provide an external positive voltage (+3.3V to +12VDC) to the PROBE (J3 Pin 7) pin to activate it. The internal 1k$\Omega$ series resistor ensures safe current limiting. Upon activation, the opto-isolator's output state will be '1'.
  - Wiring for Contact Probes or PNP Probes: Connect one lead of your probe to the PROBE (J3 Pin 7). Connect the other lead of your probe to a reliable +5VDC (J3 Pin 1) or +12VDC (J22 Pin 1) source. When the tool touches the probe plate or the PNP probe triggers, it provides the positive voltage to the PROBE input pin.

Configuration in GRBLHAL ($settings):

The probe input is typically pre-configured and associated with the G38.2 (straight probe) or G38.3 (straight probe towards) G-code commands.

- $6 - Probe pin invert, boolean: This setting specifically inverts the logic of GRBLHAL's interpretation of the probe pin.
  - Determine the Physical State When Triggered:
    - If your hardware setup (jumper + probe wiring) causes the PROBE input pin to go LOW (0V) when the probe is triggered, then setting $6=0 (not inverted) will usually be correct for GRBLHAL to see it as active.
    - If your hardware setup causes the PROBE input pin to go HIGH (positive voltage) when the probe is triggered, then setting $6=1 (inverted) will usually be correct for GRBLHAL to see it as active.
  - Testing Probe Logic: A simple way to check the input state in GRBLHAL is to type ? in the console. The status report will include Pn:P if the probe is currently triggered, and nothing if it's open. Adjust $6 until the Pn:P status accurately reflects the physical state of your probe.

Using the Probe:

Once wired and configured, you use G38.2 or G38.3 G-code commands from your control software to initiate probing cycles. For example, G38.2 Z-20 F100 would tell the machine to move the Z-axis down at 100 mm/min until the probe triggers or it moves 20mm. The machine will then report the exact Z-coordinate where the probe triggered. Control software often has built-in macros or functions to simplify probing routines (e.g., tool length setting, work zero finding).

#### <a id="section-3-5-3-control-inputs-feed-hold-cycle-start-resume-reset"></a>3.5.3 Control Inputs (Feed Hold, Cycle Start/Resume, Reset)

The JAYTEK controller supports physical push-buttons for essential machine control functions, providing immediate tactile interaction during operation. These inputs, like the limit switches and probe, are opto-isolated and configurable for active low input or active high input via the onboard INPUT JUMPERS. They also share the 12V tolerance, 1k$\Omega$ series resistor, and 60mA opto-coupler limit, ensuring robust and flexible connectivity for various types of buttons or external control signals.

These control inputs are located on the CONTROL INPUT – J3 header:

PIN | FUNCTION | DIRECTION
1 | 5V | OUT
2 | GND | COMMON
3 | CYCLE START | IN
4 | CYCLE HOLD | IN
5 | EMERGENCY STOP | IN
6 | RESET | IN
7 | PROBE | IN
8 | DOOR | IN

Wiring Control Inputs (Feed Hold, Cycle Start/Resume, Reset):

These inputs are typically connected to momentary push buttons. The wiring approach depends on how you set the corresponding "INPUT JUMPER" for J3 (refer to your Board Layout Diagram for specific jumper locations).

- Jumper Setting for "Active Low Input" (Requires External 0V/GND for Activation):
  - Internal Configuration: The opto-isolator's internal LED has its anode connected to +5VDC via the jumper.
  - External Signal Required for Activation: To activate the input, you must provide a GND (0V) signal to the corresponding input pin when the button is pressed. Upon activation, the opto-isolator's output state will be '1'.
  - Wiring for Push Buttons: Connect one terminal of your momentary push button to the desired CONTROL INPUT pin (J3 Pin 3 for Cycle Start, J3 Pin 4 for Cycle Hold, J3 Pin 6 for Reset). Connect the other terminal of the push button to GND (J3 Pin 2). When pressed, the button will pull the input pin to GND.
- Jumper Setting for "Active High Input" (Requires External +Voltage for Activation):
  - Internal Configuration: The opto-isolator's internal LED has its cathode connected to GND via the jumper.
  - External Signal Required for Activation: To activate the input, you must provide an external positive voltage (+3.3V to +12VDC) to the corresponding input pin when the button is pressed. The internal 1k$\Omega$ series resistor safely limits the current. Upon activation, the opto-isolator's output state will be '1'.
  - Wiring for Push Buttons: Connect one terminal of your momentary push button to the desired CONTROL INPUT pin (J3 Pin 3 for Cycle Start, J3 Pin 4 for Cycle Hold, J3 Pin 6 for Reset). Connect the other terminal of the push button to +5V (J3 Pin 1) or an external +12V (J22 Pin 1) source. When pressed, the button will provide the positive voltage to the input pin.

GRBLHAL Configuration ($settings) for Control Inputs:

Like other inputs, the behavior of these control inputs can be influenced by GRBLHAL's $settings.

- $5 - Input port invert mask, int: This setting is crucial for telling GRBLHAL how to interpret the physical state (LOW or HIGH) of these input pins as "active."
  - Determine the Physical State When Activated:
    - If your hardware setup (jumper + button wiring) causes the input pin to go LOW (0V) when the button is pressed (activated), then setting the corresponding bit in $5 to 0 (not inverted) will generally be correct for GRBLHAL to see it as active.
    - If your hardware setup causes the input pin to go HIGH (positive voltage) when the button is pressed (activated), then setting the corresponding bit in $5 to 1 (inverted) will generally be correct for GRBLHAL to see it as active.
  - Bitmask Values for $5 for Control Inputs:
    - Hold: 512 (for Cycle Hold/Feed Hold)
    - Start: 1024 (for Cycle Start/Resume)
    - Reset: 4096 (for Controller Reset - typically a system-level reset, not a soft reset)
    - Add the values for any inputs you need to invert. For example, if your Cycle Start and Feed Hold buttons are wired to go HIGH when pressed, and GRBLHAL expects LOW for active, you would set $5=1536 (512 + 1024).
  - Testing Input Logic: You can monitor the state of these inputs by typing ? in the GRBLHAL console. The status report will show Pn:S for Cycle Start, Pn:H for Hold, and other relevant codes. Adjust $5 until the Pn: status accurately reflects the physical state of your buttons.
- Functionality of Control Inputs:
  - Feed Hold (J3 Pin 4): When activated, GRBLHAL will pause the current motion and spindle/coolant operations. The machine will decelerate to a stop. Pressing Cycle Start/Resume will resume the program.
  - Cycle Start/Resume (J3 Pin 3): When activated, GRBLHAL will start or resume a paused G-code program.
  - Reset (J3 Pin 6): When activated, this typically performs a full GRBLHAL reset, clearing all commands in the buffer, stopping motion, and resetting the machine to an idle state. This is similar to sending a software reset command (Ctrl+X or 0x18) and should be used with caution as it will abort the current job.

#### <a id="section-3-5-4-emergency-stop-e-stop"></a>3.5.4 Emergency Stop (E-Stop)

The Emergency Stop (E-Stop) input is the most critical safety feature on your CNC controller. Its primary purpose is to immediately and forcefully halt all machine motion and operations in case of an emergency, preventing injury to the operator or damage to the machine and workpiece.

Like all other digital inputs on the JAYTEK controller, the E-Stop input is opto-isolated and its logic can be configured for active low input or active high input via the onboard INPUT JUMPERS. It also shares the 12V tolerance, 1k$\Omega$ series resistor, and 60mA opto-coupler limit, ensuring robust and flexible connectivity.

The Emergency Stop input is located on the CONTROL INPUT – J3 header:

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

Crucial Safety Warning for E-Stop Implementation:

The JAYTEK controller's E-Stop input serves to signal the GRBLHAL firmware to stop motion and enter an alarm state. However, a true, comprehensive Emergency Stop system should not rely solely on this software-level signal. It is paramount that your E-Stop button's wiring and overall machine design also incorporate a mechanism to immediately and physically cut power to all high-voltage components, especially motors/drives and the spindle. This typically involves using external safety relays, contactors, or dedicated safety modules that are activated (de-energized) by the E-Stop button.

Reasoning: In the event of a controller malfunction, a software crash, or a drive failure, the E-Stop signal to the controller might not be sufficient to bring the machine to a safe halt. A hardwired power cut ensures that all dangerous motion and operations cease, regardless of the controller's state.

Wiring the Emergency Stop Button:

Critical Safety Recommendation: Always wire E-Stop buttons as Normally Closed (NC) for Fail-Safe Operation.

- Normally Closed (NC) E-Stop Buttons: An NC button maintains a closed circuit (continuity) under normal conditions. When pressed, it opens the circuit. This is crucial for safety because if a wire breaks, comes loose, or the button itself fails (to an open circuit), the E-Stop will automatically trigger, immediately halting the machine. This "fail-safe" behavior is paramount for E-Stop functionality.

The wiring approach to the JAYTEK controller's E-Stop input depends on how you set the corresponding "INPUT JUMPER" for J3 (refer to your Board Layout Diagram for specific jumper locations).

- Jumper Setting for "Active Low Input" (Recommended for NC E-Stop Buttons, Requires External 0V/GND for Activation):
  - Internal Configuration: The opto-isolator's internal LED has its anode connected to +5VDC via the jumper.
  - External Signal Required for Activation (E-Stop Triggered): To cause an E-Stop, the signal on the input pin must stop providing GND (0V). Normally, the button will provide GND. When pressed, it opens the circuit, causing the pin to go high (deactivating the opto-isolator).
  - Wiring for NC Push Button: Connect one terminal of your Normally Closed (NC) momentary push button to the EMERGENCY STOP (J3 Pin 5). Connect the other terminal of the push button to GND (J3 Pin 2).
    - Normal State (Button Not Pressed): The NC button is closed, pulling J3 Pin 5 to GND. This activates the input (as per "Active Low Input" definition), and GRBLHAL interprets this as the safe, non-E-stop state.
    - E-Stop Activated (Button Pressed or Wire Broken): The NC button opens, or the wire breaks. This causes J3 Pin 5 to float high (or be pulled high by GRBLHAL's internal pull-up). This deactivates the input, and GRBLHAL interprets this change as an E-Stop condition.
- Jumper Setting for "Active High Input" (Less Common for E-Stop, Requires External +Voltage for Activation):
  - Internal Configuration: The opto-isolator's internal LED has its cathode connected to GND via the jumper.
  - External Signal Required for Activation (E-Stop Triggered): To cause an E-Stop, you must provide a positive voltage (+3.3V to +12VDC) to the input pin.
  - Wiring for NC Push Button (to achieve fail-safe with Active High Jumper): Connect one terminal of your Normally Closed (NC) momentary push button to a +5V (J3 Pin 1) or +12V (J22 Pin 1) source. Connect the other terminal of the push button to the EMERGENCY STOP (J3 Pin 5).
    - Normal State (Button Not Pressed): The NC button is closed, providing +5V/+12V to J3 Pin 5. This activates the input (as per "Active High Input" definition), and GRBLHAL interprets this as the safe, non-E-stop state.
    - E-Stop Activated (Button Pressed or Wire Broken): The NC button opens, or the wire breaks. This causes J3 Pin 5 to drop to 0V (deactivating the opto-isolator). GRBLHAL interprets this change as an E-Stop condition.

GRBLHAL Configuration ($settings) for E-Stop:

The E-Stop input is monitored at a very low level by GRBLHAL for immediate response.

- $5 - Input port invert mask, int: This setting tells GRBLHAL whether to interpret a physical "low" (0V) or "high" (positive voltage) state on the E-Stop pin as "active" (meaning the machine is not in E-stop).
  - Determine the Physical State of the E-Stop Pin When NOT Pressed (Normal Operation):
    - If your E-Stop is wired such that the EMERGENCY STOP (J3 Pin 5) pin is LOW (0V) during normal, non-E-stop operation, then setting the E-Stop: 8192 bit in $5 to 0 (not inverted) will usually be correct for GRBLHAL to see it as "safe." When the E-Stop is triggered, the pin goes HIGH, and GRBLHAL interprets this as an E-Stop.
    - If your E-Stop is wired such that the EMERGENCY STOP (J3 Pin 5) pin is HIGH (positive voltage) during normal, non-E-stop operation, then setting the E-Stop: 8192 bit in $5 to 1 (inverted) will usually be correct for GRBLHAL to see it as "safe." When the E-Stop is triggered, the pin goes LOW, and GRBLHAL interprets this as an E-Stop.
  - Example: If your E-Stop is wired as NC and connected to GND via the "Active Low Input" jumper setting (J3 Pin 5 is LOW normally), then 8192 should not be included in the $5 mask. If it's wired to be HIGH normally, then 8192 should be included.
  - Testing E-Stop Logic: Type ? in the GRBLHAL console. When the E-Stop is not pressed, the machine should be in an Idle or Run state, and Pn:E should not appear in the status report. When the E-Stop is pressed, the machine should immediately go into an Alarm state, and Pn:E should appear. Adjust the 8192 bit in $5 until this behavior is correct.
- E-Stop Behavior in GRBLHAL:
  - When the E-Stop input is triggered, GRBLHAL immediately kills all motion, disables steppers, and typically enters an Alarm state (e.g., Alarm:1 Hard limit triggered).
  - In the Alarm state, all G-code commands are ignored. To recover, you typically need to release the E-Stop button and then send a $ (soft reset) or Ctrl+X command to clear the alarm and return the machine to an Idle state. You may then need to re-home the machine ($H) before resuming operations.

### <a id="section-3-6-coolant-outputs-mist-and-flood"></a>3.6 Coolant Outputs (Mist and Flood)

The JAYTEK controller provides dedicated outputs for controlling both Mist and Flood coolant systems. These are 5V logic-level control signals specifically designed to activate external Solid State Relays (SSRs) or pre-built relay modules, which in turn switch the power to your coolant pumps or solenoids.

These coolant control signals are located on the COOLANT OUTPUT – J12 header:

PIN | FUNCTION | DIRECTION
1 | MIST | OUT (5V Logic)
2 | FLOOD | OUT (5V Logic)

Electrical Characteristics and Wiring

The Mist Coolant (J12 Pin 1) and Flood Coolant (J12 Pin 2) outputs provide a 5V logic signal (typically active HIGH) when activated by GRBLHAL. They are not designed to directly power your coolant pumps or solenoids, nor are they intended for direct connection to the coils of standard electromagnetic relays. Their purpose is to supply a low-current control signal to the input of a compatible external Solid State Relay (SSR) or a relay module that accepts a 5V logic trigger.

Wiring an External 5V-Compatible Relay Module or SSR:

1. Connect the signal input pin of your 5V-compatible relay module (or SSR) to either:
  - MIST (J12 Pin 1) for mist control.
  - FLOOD (J12 Pin 2) for flood control.
2. Ensure that the GND connection of your relay module (or SSR) is connected to a common ground point with the JAYTEK board. This common ground could be from a dedicated GND pin on J12 (if available, consult your Board Layout Diagram) or any other common GND point on the JAYTEK board (e.g., J2 Pin 2 or J3 Pin 2).
3. Provide the necessary VCC (typically 5V for module power, if required) to your relay module from a suitable 5V source, such as the 5V pin on J3 (Pin 1) or J2 (Pin 1), or a dedicated 5V power supply.

When the corresponding M-code (see below) is issued, the JAYTEK board will drive the respective output pin on J12 to 5V, which in turn triggers your external relay module or SSR. The high-current contacts of this external relay/SSR are then used to safely switch the power for your coolant pump or solenoid.

GRBLHAL Control and Configuration for Coolant Outputs

Coolant outputs in GRBLHAL are primarily controlled directly via standard G-code M-commands. Unlike some inputs which have $settings for polarity inversion, there are typically no direct $settings in GRBLHAL to invert the output polarity of the M7/M8/M9 coolant signals. These outputs are designed to provide a 5V (logic HIGH) signal when active.

- M7: Activates the Mist Coolant output (J12 Pin 1 goes to 5V).
- M8: Activates the Flood Coolant output (J12 Pin 2 goes to 5V).
- M9: Deactivates all coolant outputs (both J12 Pin 1 and Pin 2 return to 0V).

These commands are typically embedded within your G-code programs by your CAM software's post-processor. For example:

- An M8 command is often placed at the beginning of a cutting path to engage flood coolant.
- An M7 command would be used similarly for mist coolant.
- An M9 command is generally placed at the end of a tool path or program segment to turn off all coolants.

### <a id="section-3-7-auxiliary-outputs-j7"></a>3.7 Auxiliary Outputs (J7)

The JAYTEK controller provides eight general-purpose auxiliary output pins on the J7 header. These outputs function as low-side drivers, making them ideal for controlling external 12V relay coils, LED indicators, or other low-current loads by providing a path to ground when activated.

These auxiliary outputs are driven by a ULN2803A Darlington Transistor Array IC, which simplifies external wiring by incorporating protection features.

These auxiliary outputs are located on the AUXILIARY OUTPUT – J7 header:

PIN | FUNCTION | DIRECTION
1 | AUXILIARY #7 | OUT (Low-Side Switch)
2 | AUXILIARY #6 | OUT (Low-Side Switch)
3 | AUXILIARY #5 | OUT (Low-Side Switch)
4 | AUXILIARY #4 | OUT (Low-Side Switch)
5 | AUXILIARY #3 | OUT (Low-Side Switch)
6 | AUXILIARY #2 | OUT (Low-Side Switch)
7 | AUXILIARY #1 | OUT (Low-Side Switch)
8 | AUXILIARY #0 | OUT (Low-Side Switch)

Electrical Characteristics and Wiring

Each output pin on J7 (AUXILIARY #0 through #7) is designed as a low-side switch. This means that when an output is activated by GRBLHAL, the corresponding pin internally connects to GND, completing a circuit for the connected load.

Each individual output on J7 is capable of sinking up to 500mA (0.5A) of current. This robust capability, provided by the ULN2803A driver IC, allows for direct control of a wide range of components without requiring an intermediate relay, such as:

- Standard 12V DC electromagnetic relay coils.
- Small 12V DC solenoids.
- Small 12V DC fans.
- LED strips or individual high-power LEDs (with appropriate current limiting resistors if needed for direct LED connection).
- Other low-power 12V or 5V DC devices that draw less than 500mA.

A significant advantage of using the ULN2803A is its built-in common-cathode clamp diodes. These diodes are internally connected across each Darlington pair and provide essential flyback protection for inductive loads (like relay coils and solenoids). This means you do not need to add external flyback diodes when connecting inductive loads to the J7 outputs, as the ULN2803A handles this protection internally.

To power your 12V loads, you can conveniently use the +12V (J22 Pin 1 (https://www.google.com/search?q=%23section-3-2-5-12v-output-j22)) and GND (J22 Pin 2 (https://www.google.com/search?q=%23section-3-2-5-12v-output-j22)) outputs available on the 5 & 12V OUTPUT – J22 header, which provide up to 3A total current. Similarly, +5V (J22 Pin 3 (https://www.google.com/search?q=%23section-3-2-5-12v-output-j22)) can be used for 5V loads.

Wiring an External Device (e.g., Relay, Small Fan, Solenoid) using J7 Auxiliary Outputs:

1. Connect the positive (+) terminal of your 12V (or 5V) device to the appropriate voltage source (e.g., +12V (J22 Pin 1 (https://www.google.com/search?q=%23section-3-2-5-12v-output-j22)) or +5V (J22 Pin 3 (https://www.google.com/search?q=%23section-3-2-5-12v-output-j22))) on the JAYTEK board.
2. Connect the negative (-) terminal of your device to the desired AUXILIARY #X (J7 Pin X) output pin (e.g., J7 Pin 8 for AUXILIARY #0 (https://www.google.com/search?q=%23section-3-2-auxiliary-output-j7)).

When the corresponding auxiliary output is activated by GRBLHAL, that J7 pin will switch to GND, completing the circuit for the connected device and activating it.

Important Considerations:

- Total Current: While each output can sink 500mA, be mindful of the total current drawn from the J22 power outputs. The 12V and 5V supplies on J22 are each rated for a maximum of 3 Amperes combined for all connected devices. Do not exceed this total capacity.
- Load Switching: For devices that draw more than 500mA, or for switching AC power, you must use an external relay or a higher-current MOSFET driver whose coil is controlled by a J7 output. Do NOT connect high-power AC or DC devices directly to the J7 output pins that exceed their 500mA sink rating.

GRBLHAL Control and Configuration

The Auxiliary Outputs on J7 are controlled using specific G-code commands in GRBLHAL. These are typically managed via the M62 and M63 commands, which are designed for precisely timed digital output control.

- M62 Px: Activates (turns ON) the auxiliary output specified by Px.
  - Px refers to the output number. For J7, AUXILIARY #0 corresponds to P0, AUXILIARY #1 to P1, and so on, up to AUXILIARY #7 for P7.
  - Example: M62 P0 would activate AUXILIARY #0 (J7 Pin 8 (https://www.google.com/search?q=%23section-3-2-auxiliary-output-j7)), causing that pin to connect to GND.
- M63 Px: Deactivates (turns OFF) the auxiliary output specified by Px.
  - Example: M63 P0 would deactivate AUXILIARY #0 (J7 Pin 8 (https://www.google.com/search?q=%23section-3-2-auxiliary-output-j7)), causing that pin to return to its high-impedance (off) state.

These commands can be embedded in your G-code programs to automate the control of external accessories during your CNC operations. For example, to turn on a vacuum pump at the start of a job and turn it off at the end:

M62 Px ; Turn on Auxiliary Output (e.g., P0 for vacuum pump)

; Your machining G-code here

M63 Px ; Turn off Auxiliary Output (e.g., P0)

There are no specific $settings in GRBLHAL to invert the polarity of these J7 outputs; they are designed to function as low-side switches (active LOW). Their behavior is directly controlled by the M62/M63 commands.

### <a id="section-3-8-expansion-breakouts-uart-i2c-spi"></a>3.8 Expansion Breakouts (UART, I2C, SPI)

The JAYTEK controller leverages the capabilities of its STM32F4xx microcontroller by providing breakout pins for several common serial communication protocols: Universal Asynchronous Receiver/Transmitter (UART), Inter-Integrated Circuit (I2C), and Serial Peripheral Interface (SPI). These breakouts allow users to connect a wide range of external peripherals, sensors, and communication modules, significantly expanding the controller's functionality beyond core CNC operations.

Important Note: Please refer to the detailed board layout diagram or the official JAYTEK controller schematic for the precise physical location (J-numbers) and pin assignments of these expansion headers on your board.

#### <a id="section-3-8-1-uart-usart-breakout"></a>3.8.1 UART (USART) Breakout

Purpose: UART (Universal Asynchronous Receiver/Transmitter), often referred to as USART (Universal Synchronous/Asynchronous Receiver/Transmitter) on STM32 microcontrollers, is a common serial communication protocol used for point-to-point data exchange. It is ideal for connecting devices that require asynchronous serial communication, such as:

- External displays (e.g., Nextion, character LCDs with serial adapters)
- Bluetooth modules
- Wi-Fi modules
- GPS modules
- Other microcontrollers or serial-enabled sensors

Typical Pin Assignments:

- TX (Transmit): Sends data from the JAYTEK controller.
- RX (Receive): Receives data into the JAYTEK controller.
- VCC (Voltage Common Collector): Provides power (typically 3.3V or 5V, depending on configuration) for the connected module. This power is usually sourced from the controller's onboard regulators.
- GND (Ground): Common ground reference for the UART communication.

#### <a id="section-3-8-2-i2c-inter-integrated-circuit-breakout"></a>3.8.2 I2C (Inter-Integrated Circuit) Breakout

Purpose: I2C is a two-wire, multi-master, multi-slave serial bus commonly used for short-distance communication between integrated circuits (ICs) on a single board or across closely connected boards. It is highly efficient for connecting multiple low-speed peripheral devices with minimal wiring. Common applications include:

- Various I2C-compatible sensors (e.g., temperature, pressure, accelerometer, gyroscope)
- Real-time clocks (RTCs)
- EEPROM memory modules
- Character LCDs with I2C backpacks
- Digital-to-Analog Converters (DACs) and Analog-to-Digital Converters (ADCs)

Typical Pin Assignments:

- SDA (Serial Data Line): Carries the data signals.
- SCL (Serial Clock Line): Carries the clock signals, synchronizing data transfer.
- VCC (Voltage Common Collector): Provides power (typically 3.3V or 5V, depending on configuration) for the connected I2C devices. This power is usually sourced from the controller's onboard regulators.
- GND (Ground): Common ground reference for the I2C communication.

#### <a id="section-3-8-3-spi-serial-peripheral-interface-breakout"></a>3.8.3 SPI (Serial Peripheral Interface) Breakout

Purpose: SPI is a synchronous serial communication interface used for high-speed, full-duplex data exchange over short distances. It operates in a master-slave configuration, where the microcontroller (master) controls one or more peripheral devices (slaves). SPI is generally faster than I2C and UART and is well-suited for:

- SD card readers (for G-code storage or logging)
- Advanced sensors requiring high data rates (e.g., some accelerometers, gyroscopes, or image sensors)
- External Flash/EEPROM memory
- Digital potentiometers
- Graphic LCDs (some types)

Typical Pin Assignments:

- MOSI (Master Out Slave In): Data line from the master (controller) to the slave.
- MISO (Master In Slave Out): Data line from the slave to the master (controller).
- SCK (Serial Clock): Clock signal generated by the master to synchronize data transfer.
- CS (Chip Select) or SS (Slave Select): A dedicated line for each slave device. The master pulls this line low to activate a specific slave for communication.
- VCC (Voltage Common Collector): Provides power (typically 3.3V or 5V, depending on configuration) for the connected SPI devices. This power is usually sourced from the controller's onboard regulators.
- GND (Ground): Common ground reference for the SPI communication.

### <a id="section-3-9-firmware-flashing-via-dfu-device-firmware-upgrade"></a>3.9 Firmware Flashing via DFU (Device Firmware Upgrade)

The JAYTEK controller's STM32F4xx microcontroller supports DFU mode, a standard mechanism for updating firmware directly over USB without the need for a dedicated programmer. This is the recommended method for installing new GRBLHAL firmware versions.

Prerequisites:

- USB-B Cable: A standard USB-A to USB-B cable to connect the controller to your PC.
- USB POWER Jumper: Ensure this jumper is correctly placed on the board if you intend to power the CPU via USB for flashing. (Refer to the board layout diagram for the jumper's precise location).
- DFU Driver: Your operating system may require a specific DFU driver for the STM32 microcontroller. On Windows, this often involves installing the STM32 DFU drivers (often found within the STM32CubeProgrammer installation or as a separate package).
- DFU Flashing Utility: Software like STM32CubeProgrammer (recommended by STMicroelectronics) or command-line tools like dfu-util are used to send the firmware file to the controller in DFU mode.
- GRBLHAL Firmware File: The .bin or .hex firmware file for your JAYTEK controller (e.g., from the JAYTEK Controller (STM32F4xx) Specific Firmware GitHub repository: https://github.com/jaytektas/STM32F4xx (https://www.google.com/search?q=https://github.com/jaytektas/STM32F4xx)).

Entering DFU Mode:

The JAYTEK controller can be put into DFU mode using two different methods, depending on the current power state of the board.

#### <a id="section-3-9-method-1-entering-dfu-mode-via-hard-reset-when-initially-unpowered-or-only-usb-powered"></a>Method 1: Entering DFU Mode via Hard Reset (when initially unpowered or only USB powered)

This method is used when the board is not actively running firmware, typically when first connecting or after a full power cycle.

1. Ensure Power Preparation: If you intend to power the board via USB for flashing, ensure the USB POWER jumper is in place. If the main 12-30VDC power supply (via J19) is connected, it is recommended to disconnect it during this process to rely solely on USB power.
2. Press and Hold BOOT: Press and hold down the BOOT button on the JAYTEK controller.
3. Connect USB Cable: While continuing to hold the BOOT button, plug the USB-B cable into the JAYTEK controller's USB port, connecting it to your PC. The controller will now power on via USB.
4. Release BOOT: After the USB cable is fully connected and the board is powered, release the BOOT button.

The controller should now be in DFU mode.

#### <a id="section-3-9-method-2-entering-dfu-mode-via-soft-reset-when-already-powered-via-j19-or-usb"></a>Method 2: Entering DFU Mode via Soft Reset (when already powered via J19 or USB)

This method is used when the board is already powered on and potentially running GRBLHAL firmware (e.g., connected via J19, or USB is already plugged in and the USB POWER jumper is in place).

1. Ensure Power: Confirm the JAYTEK controller is powered (either via J19 or with the USB cable plugged in and the USB POWER jumper in place).
2. Press and Hold BOOT: Press and hold down the BOOT button on the JAYTEK controller.
3. Momentarily Press RESET: While still holding the BOOT button, briefly press and then release the RESET button on the board.
4. Release BOOT: After pressing and releasing the RESET button, release the BOOT button.

In both methods, once in DFU mode, the JAYTEK controller will typically not enumerate as a standard COM port in your computer's Device Manager. Instead, it will appear as a DFU device (often under "Universal Serial Bus devices" or "STM32 Bootloader"), indicating it's ready to receive firmware.

Flashing the Firmware:

1. Open DFU Utility: Launch your chosen DFU flashing utility (e.g., STM32CubeProgrammer).
2. Connect to Device: In the utility, select the DFU device and click the "Connect" or "Refresh" button. The utility should detect the JAYTEK controller in DFU mode.
3. Load Firmware: Browse to and load the GRBLHAL firmware file (.bin or .hex) you wish to flash.
4. Erase & Program: Follow the utility's instructions to erase the existing firmware and program the new firmware onto the device. Ensure the programming options are correctly set (e.g., "Verify programming").
5. Disconnect/Reset: Once the flashing process is complete, disconnect the USB cable and then reconnect it, or simply press the RESET button on the controller. The controller will then boot into the newly flashed GRBLHAL firmware.

Important Note on GRBLHAL Settings After Flashing:

Flashing new firmware will typically reset all your GRBLHAL settings ($$ settings) to their default values. This is because the firmware overwrites the memory area where these settings are stored.

- Backup Your Settings: Before flashing new firmware, it is highly recommended to backup your current GRBLHAL settings. You can do this by connecting to the controller via your CNC control software (e.g., ioSender, UGS) and sending the $$ command. Copy and save the output to a text file.
- Review New Firmware Requirements: Be aware that new firmware versions, especially those with significant updates, may introduce modified or new settings. Your previously backed-up settings might not be fully compatible or optimal with the new firmware. Always check the release notes or documentation for the new GRBLHAL firmware version for any required $settings changes or additions before attempting to use your machine. You may need to manually re-enter or adjust settings after flashing to ensure proper operation.

## <a id="section-3-10-powering-the-controller"></a>3.10 Powering the Controller

Properly powering your JAYTEK controller is essential for its stable operation and the safety of your entire CNC system. This section details the various power input options and the usage of the onboard power supplies.

### <a id="section-3-10-1-main-power-input-j19"></a>3.10.1 Main Power Input (J19)

The primary power input for the JAYTEK controller is via the 12 – 24VDC IN SUPPLY – J19 header. This connection provides the main power for the controller's internal electronics and its onboard regulated power supplies. For the controller to operate fully, a suitable power supply must be connected to J19.

PIN | FUNCTION | DIRECTION
1 | GND | COMMON
2 | +12V | IN

Input Power Requirements:

- Voltage Range: The JAYTEK controller accepts a DC input voltage ranging from 12V to 30V DC.
- Preferred Voltage: For optimal performance and compatibility with common CNC setups, 24V DC is the preferred main power input voltage.
- Current Rating: The minimum current rating of your external power supply should be sufficient to power the controller itself and any devices drawing power from its onboard 12V and 5V outputs (see Section 3.10.3 On-board Power Supply Outputs (https://www.google.com/search?q=%23section-3-10-3-on-board-power-supply-outputs)). A power supply with at least 1A to 2A capacity is generally recommended for the controller's main input, assuming typical loads on the onboard supplies. Always ensure your power supply can handle the combined current draw.

Connector Type:

- The J19 header uses screw terminals, allowing for a secure and robust connection of your power supply wires. Ensure the wires are stripped to the appropriate length and securely tightened to prevent loose connections, which can cause intermittent issues or overheating.

Crucial: Polarity Diagram and Warning:

WARNING: Connecting the power supply with reverse polarity will cause immediate and irreversible damage to the JAYTEK controller. Always double-check your connections before applying power.

(Image or Diagram Placeholder - Please refer to your physical manual or JAYTEK documentation for a clear polarity diagram of J19, showing +VDC and GND connections.)

How to Connect the Main Power Supply:

1. Identify Polarity: Carefully identify the positive (+) and negative (GND / -) terminals on your external DC power supply.
2. Connect Wires:
  - Connect the positive (+) output of your external DC power supply to PIN 2 (+12V) on the J19 header.
  - Connect the negative (-) / GND output of your external DC power supply to PIN 1 (GND) on the J19 header.
3. Secure Connection: Tighten the screw terminals firmly to ensure a good electrical contact.
4. Verify: Before applying power, use a multimeter to verify that the voltage at the J19 terminals matches your power supply's output and that the polarity is correct.

### <a id="section-3-10-2-usb-power"></a>3.10.2 USB Power

The JAYTEK controller can also be powered via its USB-B port. This is primarily intended for:

- Bench Programming: For initial setup, firmware flashing (DFU mode), and configuration without needing a separate main power supply.
- Low-Power Testing: For testing basic connectivity and communication with control software when high-power components (stepper motors, spindle) are not connected or enabled.

Limitations of USB Power:

- Limited Current: USB power (typically 5V at up to 500mA for USB 2.0, or more for USB 3.0/C) is generally insufficient to power the entire CNC system, including stepper drivers and spindles.
- Onboard Supplies: When powered only by USB, the onboard 12V and 5V power supplies (J22, etc.) will not be active, as they require the main 12-30VDC input from J19. Only the microcontroller and basic logic circuits will be powered.
- USB POWER Jumper: Ensure the "USB POWER" jumper on the board is correctly placed if you intend to power the controller via USB. Refer to your board layout diagram for its location.

#### <a id="section-3-10-2-1-cpu-3-3v-derivation-j18"></a>3.10.2.1 CPU 3.3V Derivation (J18)

The JAYTEK controller's CPU (STM32F407VET6) requires a stable 3.3V power source. The J18 (3-pin) jumper allows you to select how this 3.3V is derived, offering flexibility for different power scenarios.

J18 Pin Functions:

- Pin 1: +5V source (typically from the onboard 5V regulator, active when main power is connected).
- Pin 2: 3.3V source (the regulated 3.3V output for the CPU core).
- Pin 3: VUSB (5V from the USB connection).

Jumper Configuration for CPU 3.3V Source:

- Normal Operation (Main Power Connected): For regular operation when the main 12-30VDC power supply is connected to J19, the 3.3V for the CPU is typically derived from the onboard 5V regulator. In this scenario, the jumper should connect Pin 1 (+5V) and Pin 2 (3.3V source). This ensures the CPU is powered from the robust onboard regulation.
- USB-only Operation (Main Power Absent): When the main power input (J19) is not present, you can power the CPU core directly from the USB connection. To do this, the jumper on J18 should connect Pin 2 (3.3V source) and Pin 3 (VUSB). This configuration allows the microcontroller to operate for tasks like firmware flashing (DFU mode) or basic communication, drawing its power directly from the USB port.

Important Considerations for J18:

- Do NOT connect the jumper across all three pins simultaneously. This could lead to conflicting power sources and potential damage.
- Ensure the correct jumper setting for your intended power source (main power vs. USB-only) to guarantee stable operation of the CPU.

### <a id="section-3-10-3-on-board-power-supply-outputs"></a>3.10.3 On-board Power Supply Outputs

The JAYTEK controller integrates robust dual Switching Mode Power Supplies (SMPS) that provide regulated 12V and 5V outputs directly on the board. These supplies are derived from the main 12-30VDC input connected to J19, eliminating the need for external power regulators for many peripherals and simplifying your machine's wiring.

These outputs are conveniently available on several headers across the board:

- 5 & 12V OUTPUT – J22:
  - PIN 1: +12V
  - PIN 2: GND (Common)
  - PIN 3: +5V
  - PIN 4: GND (Common)
- LIMIT INPUT – J2:
  - PIN 1: 5V
  - PIN 2: GND (Common)
- CONTROL INPUT – J3:
  - PIN 1: 5V
  - PIN 2: GND (Common)
- DIGITAL 0..3 INPUT – J5:
  - PIN 1: 5V
  - PIN 2: GND (Common)
- DIGITAL 4..7 INPUT – J4:
  - PIN 1: 5V
  - PIN 2: GND (Common)
- ABC STEP OUTPUT – J10:
  - PIN 8: +5V
  - PIN 7: GND (Common)
- XYZ STEP OUTPUT – J9:
  - PIN 8: +5V
  - PIN 7: GND (Common)
- 5V OUT – J21:
  - PIN 1: +5V
  - PIN 2: GND (Common)

Maximum Current Ratings:

Both the 12V and 5V onboard power supplies are each capable of delivering a maximum of 3 Amperes (3A) of current. This is the total combined current that can be drawn from all pins sourcing that particular voltage rail across the entire board (e.g., all 5V pins collectively cannot exceed 3A).

Usage:

These onboard power supplies are ideal for powering low-current control electronics, sensors, and auxiliary components directly from the controller, such as:

- Limit switches and proximity sensors (if powered by 5V or 12V).
- Probes.
- Low-power auxiliary cooling fans.
- LED indicators.
- Small relay modules (e.g., for coolant control).
- UART, I2C, or SPI communication modules.

WARNINGS:

- DO NOT EXCEED CURRENT LIMITS: Exceeding the 3A current limit for either the 12V or 5V rail can lead to overheating, damage to the onboard power supplies, and potentially irreversible damage to the JAYTEK controller. Always calculate the total current draw of all connected peripherals (sensors, relays, fans, communication modules, etc.) to ensure it stays well within these limits.
- PROPER POLARITY IS CRITICAL: Always double-check your wiring to ensure correct polarity (+V to +V, GND to GND). Reversing polarity can instantly destroy connected components and the JAYTEK controller itself. Use a multimeter to verify voltage and polarity before connecting any devices.
- NOT FOR HIGH-POWER DEVICES: These onboard power supplies are designed for low-power control electronics. They are NOT suitable for powering high-current devices suchs as stepper motor drivers, spindle motors, or heavy-duty solenoids. Stepper motor drivers and high-power spindles require their own dedicated, appropriately rated external power supplies.

### <a id="section-3-10-4-isolated-grounding-philosophy"></a>3.10.4 Isolated Grounding Philosophy

The JAYTEK controller is designed with an "isolated grounding philosophy" to maximize noise immunity and protect its sensitive electronics from interference generated by high-current components like stepper motors and spindles. This approach is crucial for stable and reliable CNC operation.

Key Principles of Isolated Grounding:

- Separate Power Grounds: The main power ground of the JAYTEK controller (connected via J19) should be kept electrically separate from the power grounds of high-current external devices, such as:
  - Dedicated power supplies for stepper motor drivers.
  - Variable Frequency Drives (VFDs) for spindles.
  - High-power external relays or solenoids.
  - The metal frame of your CNC machine (which should have its own dedicated earth ground).
- Signal Ground Reference: When connecting control signals between the JAYTEK controller and external devices (e.g., Step/Dir/Enable signals to stepper drivers, PWM/Analog signals to VFDs), the controller's ground should be connected to the logic/signal ground of the external device only for signal referencing. This connection should not be used to carry the high-current return path of the external device's power supply.
- Opto-Isolation (Preferred): Ideally, external devices (stepper drivers, VFDs, etc.) should feature opto-isolated inputs for their control circuits. Opto-isolation provides a complete electrical separation (using light) between the JAYTEK controller's logic circuits and the external device's power circuits. This is the most effective way to prevent noise and ground loops from affecting the controller.
- Powering Inputs from Controller: To maintain this isolation and minimize noise, it is highly recommended that all input signals (limit switches, probe, control inputs) are powered directly from the JAYTEK controller's onboard 5V or 12V outputs. This ensures that the entire signal loop for these inputs is confined to the controller's isolated ground plane, preventing external noise from entering the sensitive input circuits.

Benefits of Isolated Grounding:

- Reduced Electrical Noise: Prevents high-current switching noise from stepper motors and VFDs from coupling into the controller's sensitive digital and analog circuits.
- Prevents Ground Loops: Eliminates unwanted current paths (ground loops) that can cause erratic behavior, missed steps, or communication errors.
- Enhanced Reliability: Contributes to a more stable and reliable CNC system, reducing unexpected stops or malfunctions.
- Improved Safety: While not a substitute for proper earth grounding, it adds another layer of protection for the controller's internal components.

By adhering to this isolated grounding philosophy, you create a robust and noise-resistant environment for your JAYTEK controller, ensuring precise and consistent machine operation.
