jaytektas/grblHAL_CNC/(commit log)

2025-06-05 grblHAL STM32 6 axis cnc controller
    [adc.kicad_sch, analog.kicad_sch, bom.csv, buffer.kicad_sch, designators.csv, digital.kicad_sch, grblHAL.csv, grblHAL.kicad_sch]
2025-06-05 added interactive bom and cleanup
    [bom.csv, designators.csv, positions.csv]
2025-06-08 added lcsc field so that bom can match during jlcpcb fab
    [analog.kicad_sch, bom.csv, buffer.kicad_sch, digital.kicad_sch, grblHAL.kicad_sch, mcu.kicad_sch, power.kicad_sch, relay.kicad_sch]
2025-07-11 moved rs485 re/de lines, start of manual
    [grblHAL.kicad_pcb, grblHAL.kicad_sch, mcu.kicad_sch]
2025-07-11 added mating push in connectors to BOM
    [bom.csv, grblHAL.kicad_pcb, grblHAL.kicad_sch, mcu.kicad_sch, power.kicad_sch]
2025-07-13 corrected top silk
    [grblHAL.kicad_pcb]
2025-08-04 silk fix
    [grblHAL.kicad_pcb]
